Karturbis/2D_Printer/electronics/main_housing.FCStd

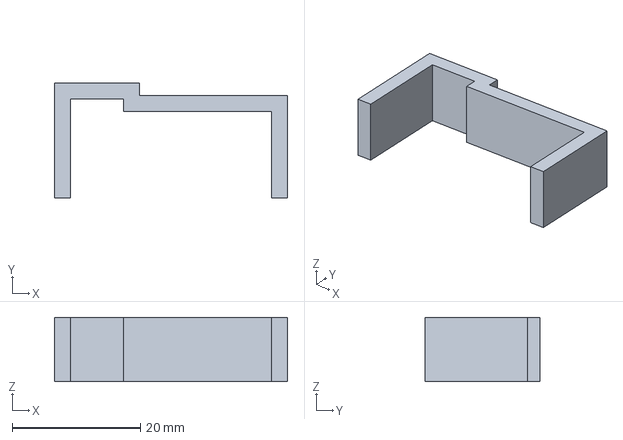
[picture p1: CAD file, 2025-06-26]
electronics/main_housing.FCStd
36.4 x 18.0 x 10.0 mm
