Karturbis/2D_Printer/electronics/stl_files/main_housing_front.stl

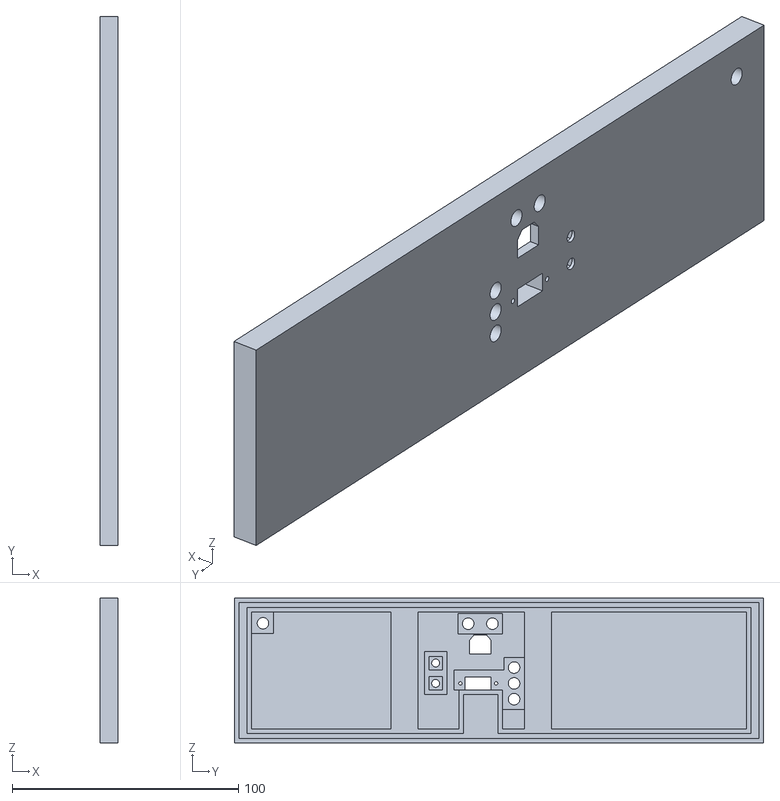
[picture p2: CAD file, 2025-06-12]
electronics/stl_files/main_housing_front.stl
8.00 x 234.0 x 64.0
