Karturbis/2D_Printer/electronics/stl_files/main_housing_back.stl

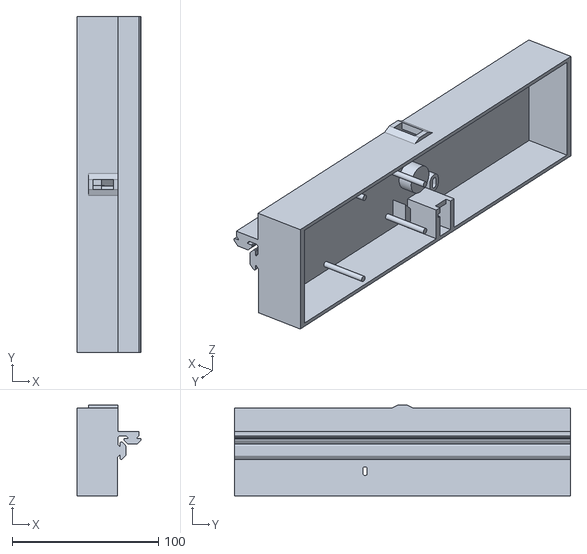
[picture p3: CAD file, 2025-06-11]
electronics/stl_files/main_housing_back.stl
44.0 x 230.0 x 62.0
