Karturbis/2D_Printer/Frame/Frame_foot.FCStd

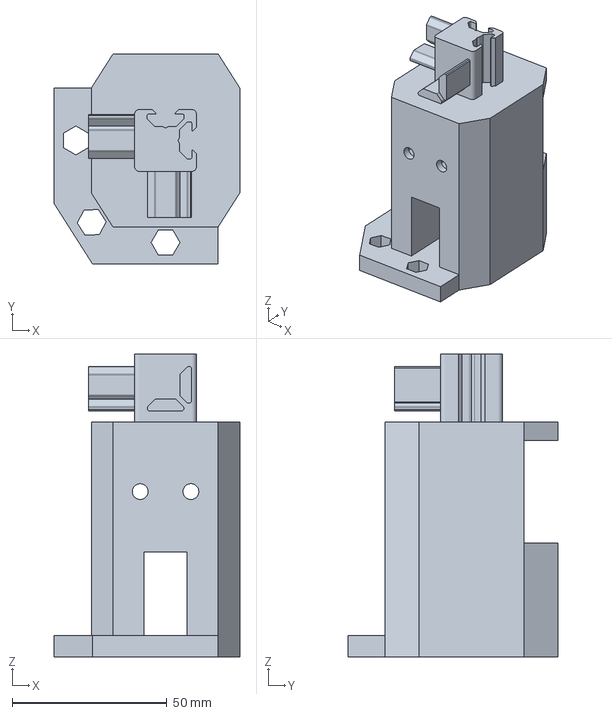
[picture p4: CAD file, 2025-06-16]
Frame/Frame_foot.FCStd
60.0 x 68.0 x 98.0 mm
