Karturbis/2D_Printer/toolhead/stl_files/one_wheel_top_pen_holder.stl

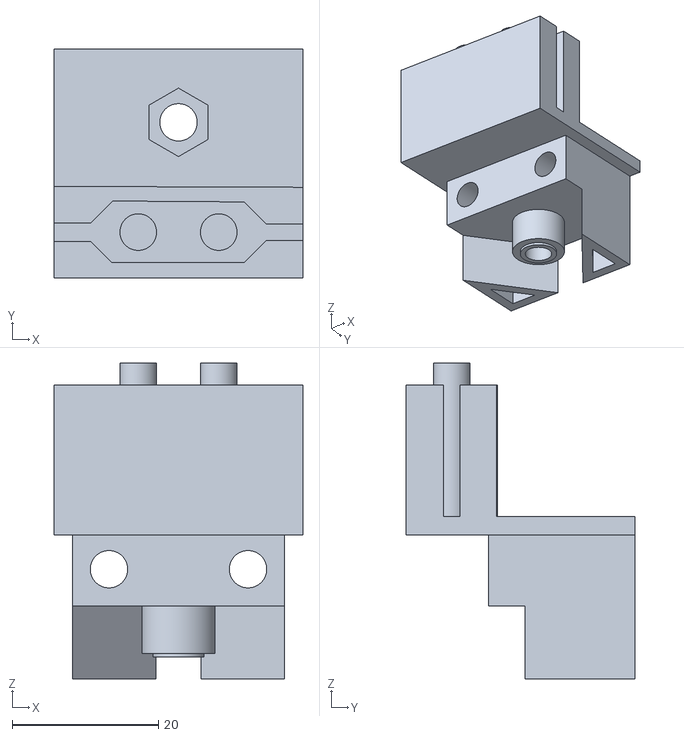
[picture p5: CAD file, 2025-06-10]
toolhead/stl_files/one_wheel_top_pen_holder.stl
34.0 x 31.3 x 43.2
