Karturbis/2D_Printer/toolhead/Toolhead.FCStd

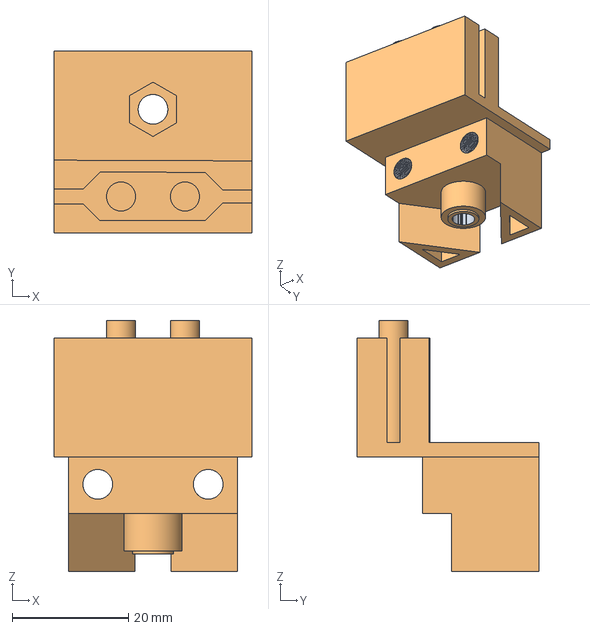
[picture p6: CAD file, 2025-06-10]
toolhead/Toolhead.FCStd
34.0 x 31.3 x 43.2 mm
one_wheel_top_pen_holder
one_wheel_top_pen_holder_mesh
