Karturbis/2D_Printer/v-slot_carriage/stl_files/y-axis_top_counter_part_left.stl

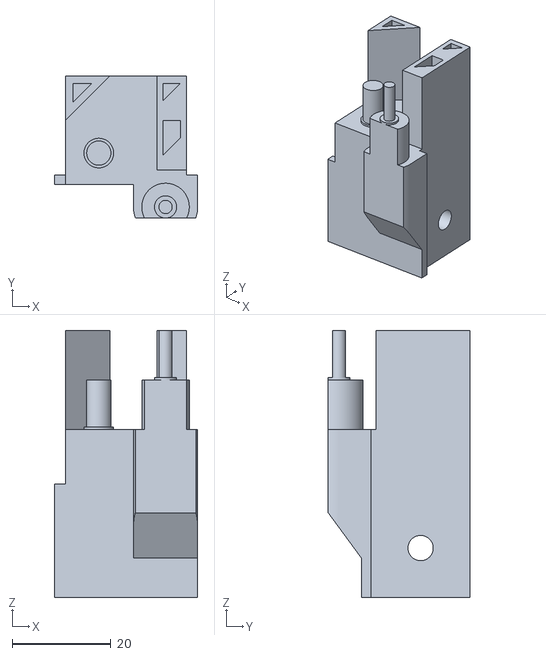
[picture p7: CAD file, 2025-06-05]
v-slot_carriage/stl_files/y-axis_top_counter_part_left.stl
29.0 x 28.8 x 54.0
