Karturbis/2D_Printer/v-slot_carriage/Vslot_carriage.FCStd

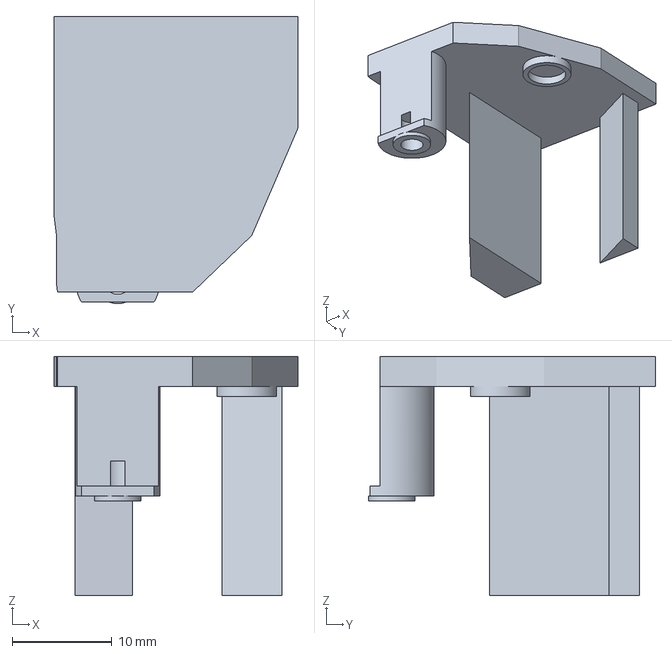
[picture p8: CAD file, 2025-06-05]
v-slot_carriage/Vslot_carriage.FCStd
24.5 x 28.9 x 24.0 mm
