Karturbis/2D_Printer/toolhead/stl_files/one_wheel_top_penholder_lid.stl

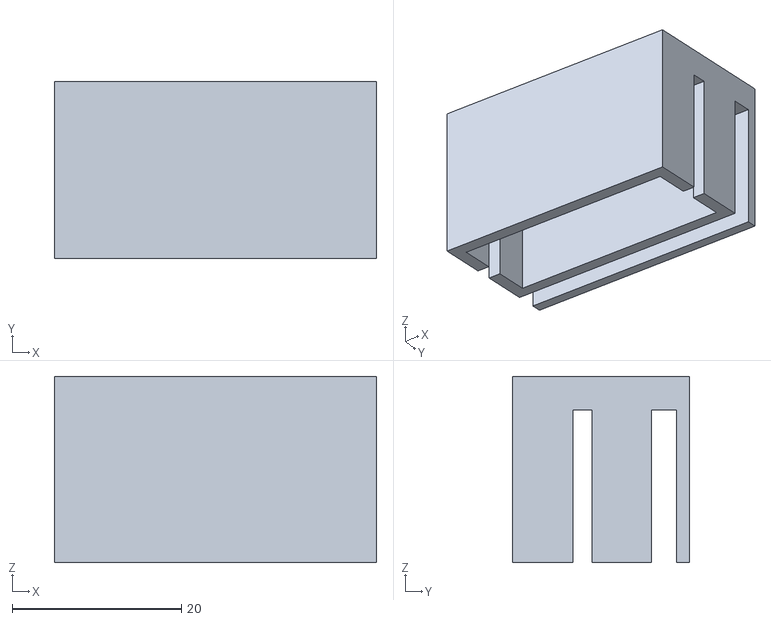
[picture p9: CAD file, 2025-06-10]
toolhead/stl_files/one_wheel_top_penholder_lid.stl
38.0 x 20.9 x 22.0
