Karturbis/2D_Printer/toolhead/stl_files/toolhead_pen_holder.stl

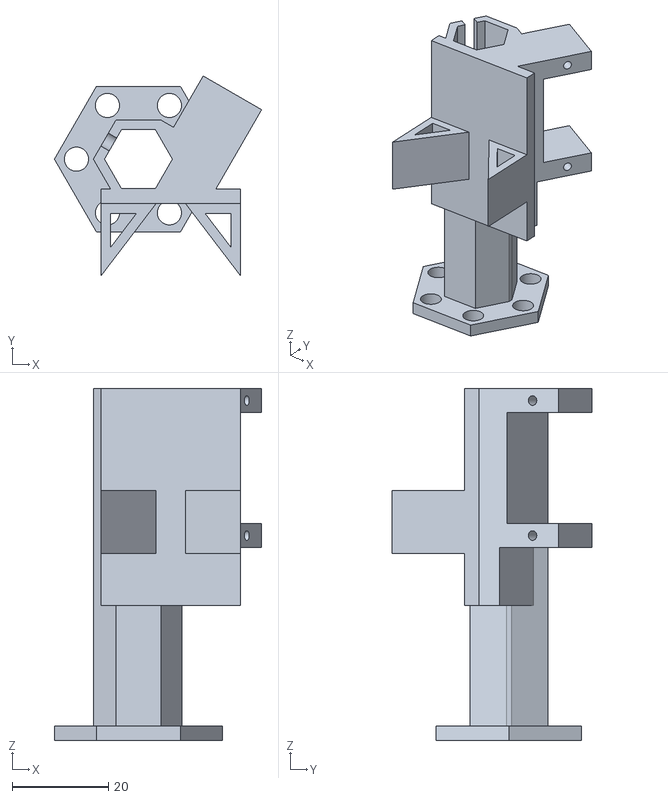
[picture p10: CAD file, 2025-05-23]
toolhead/stl_files/toolhead_pen_holder.stl
43.0 x 41.5 x 73.0
