Karturbis/2D_Printer/v-slot_carriage/stl_files/y-axis_top_counter_part_right.stl

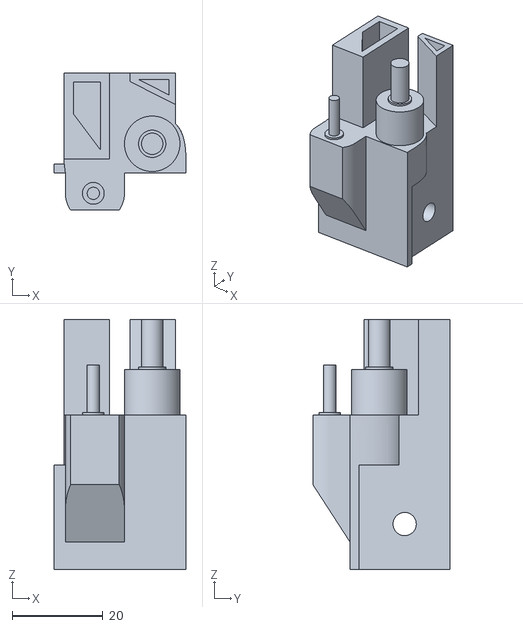
[picture p11: CAD file, 2025-06-04]
v-slot_carriage/stl_files/y-axis_top_counter_part_right.stl
29.0 x 30.2 x 55.0
