Karturbis/2D_Printer/toolhead/stl_files/Servo_Knob.stl

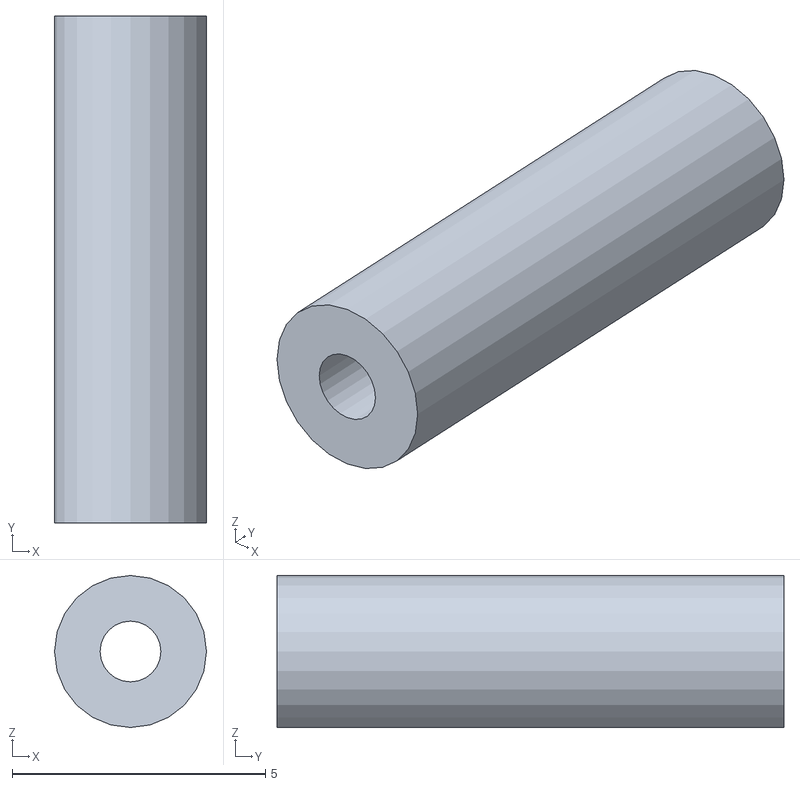
[picture p12: CAD file, 2025-05-19]
toolhead/stl_files/Servo_Knob.stl
3.00 x 10.0 x 3.00
