Karturbis/2D_Printer/v-slot_carriage/stl_files/y-axis_top_counter_part_left_lid.stl

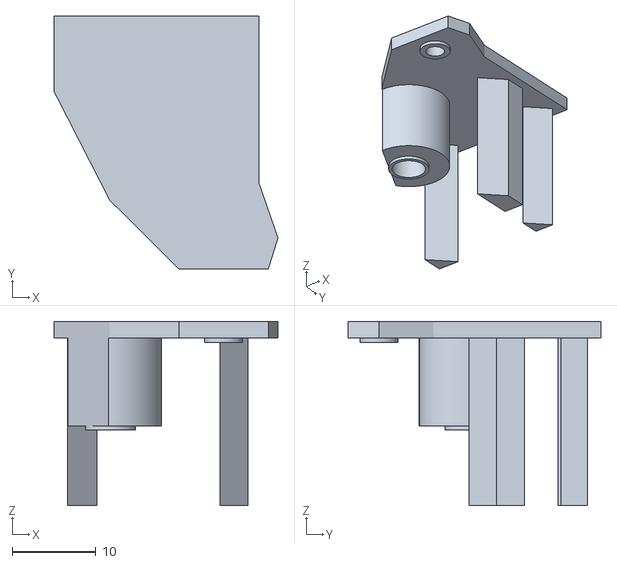
[picture p13: CAD file, 2025-06-04]
v-slot_carriage/stl_files/y-axis_top_counter_part_left_lid.stl
26.8 x 30.2 x 22.0
