Karturbis/2D_Printer/toolhead/stl_files/Pen_Holder_Stationary.stl

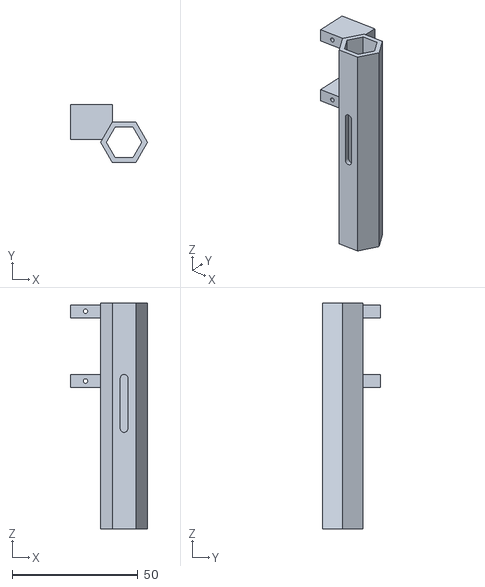
[picture p14: CAD file, 2025-05-19]
toolhead/stl_files/Pen_Holder_Stationary.stl
30.7 x 23.2 x 90.0
