Karturbis/2D_Printer/v-slot_carriage/stl_files/One_wheel_bottom.stl

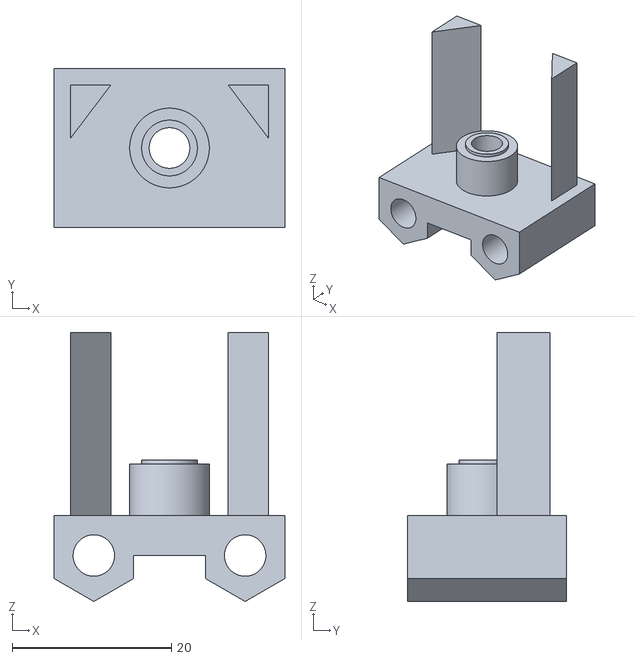
[picture p15: CAD file, 2025-06-02]
v-slot_carriage/stl_files/One_wheel_bottom.stl
29.0 x 20.0 x 33.8
