Karturbis/2D_Printer/toolhead/stl_files/Pen_Case.stl

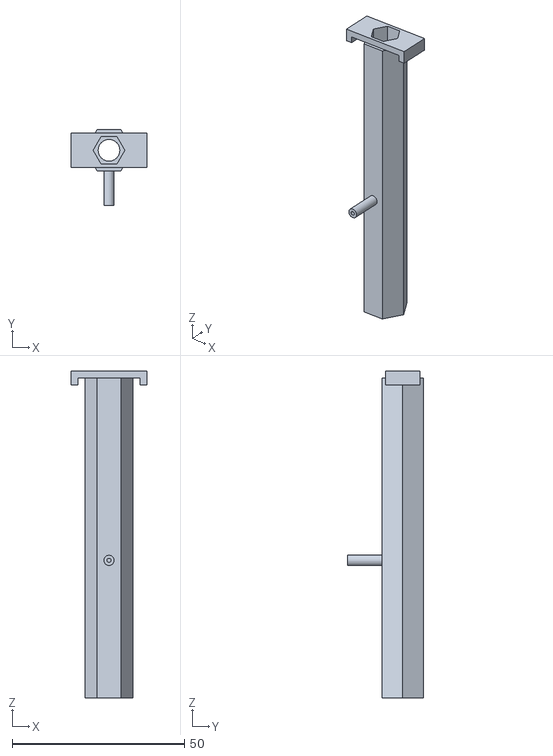
[picture p16: CAD file, 2025-05-19]
toolhead/stl_files/Pen_Case.stl
22.0 x 22.0 x 95.0
