Karturbis/2D_Printer/v-slot_carriage/stl_files/y-axis_top.stl

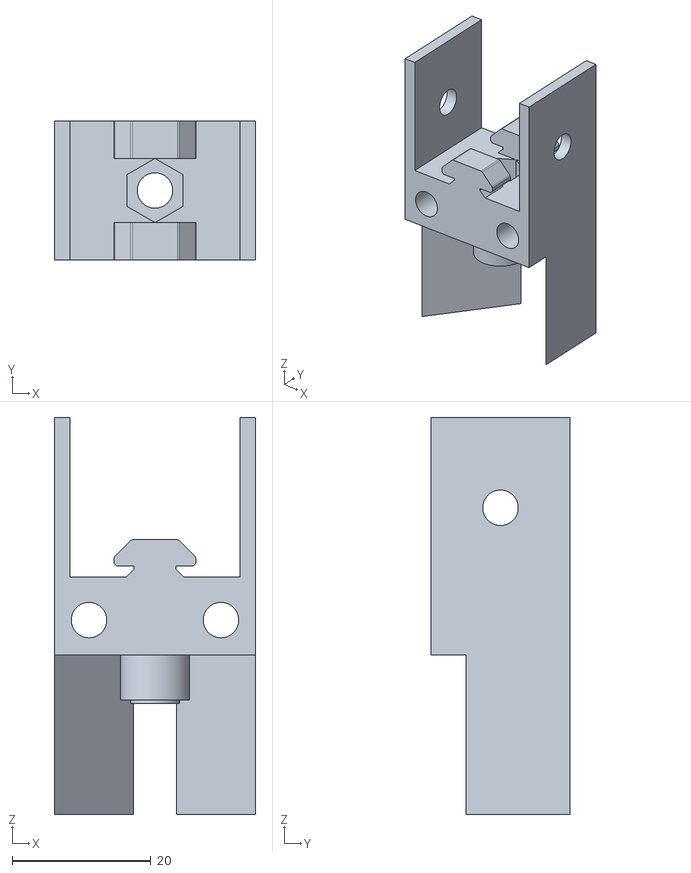
[picture p17: CAD file, 2025-06-02]
v-slot_carriage/stl_files/y-axis_top.stl
29.0 x 20.0 x 57.2
