Karturbis/2D_Printer/toolhead/stl_files/Pen_Cap.stl

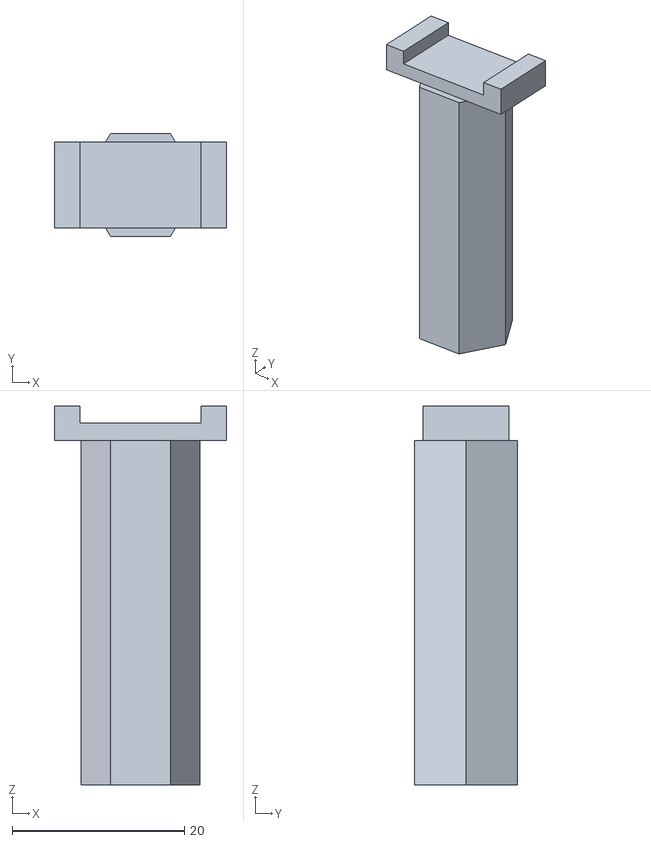
[picture p18: CAD file, 2025-05-14]
toolhead/stl_files/Pen_Cap.stl
20.0 x 12.0 x 44.0
