Karturbis/2D_Printer/v-slot_carriage/stl_files/y-axis_top_teeth_roller_lock.stl

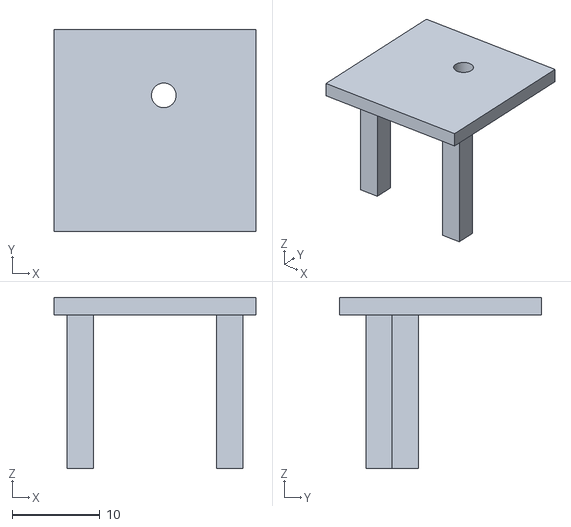
[picture p19: CAD file, 2025-06-02]
v-slot_carriage/stl_files/y-axis_top_teeth_roller_lock.stl
23.0 x 23.0 x 19.5
