Karturbis/2D_Printer/v-slot_carriage/stl_files/One_wheel_top_y-axis.stl

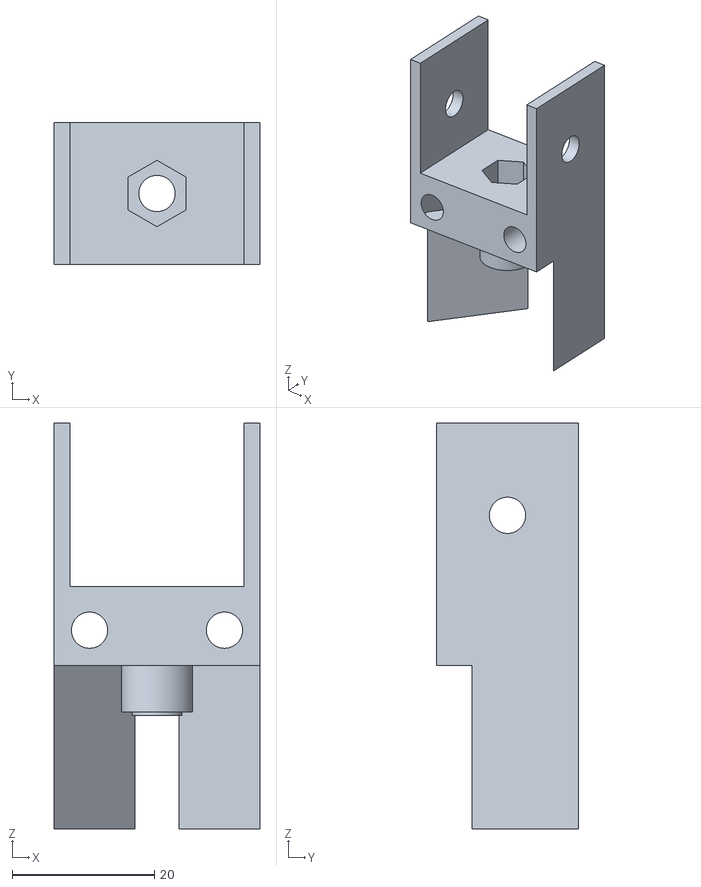
[picture p20: CAD file, 2025-05-22]
v-slot_carriage/stl_files/One_wheel_top_y-axis.stl
29.0 x 20.0 x 57.2
