Karturbis/2D_Printer/v-slot_carriage/stl_files/Belt_clip_test.stl

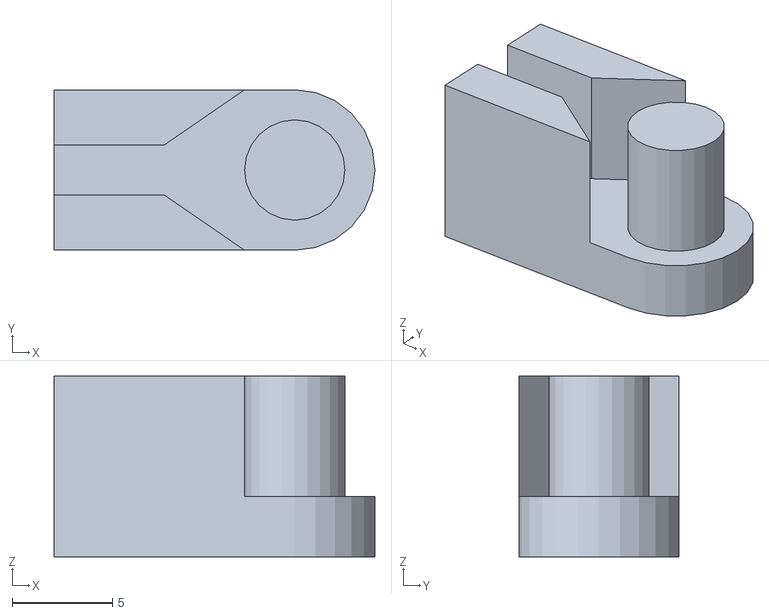
[picture p21: CAD file, 2025-05-21]
v-slot_carriage/stl_files/Belt_clip_test.stl
16.0 x 8.00 x 9.00
