Karturbis/2D_Printer/v-slot_carriage/stl_files/One_wheel_top.stl

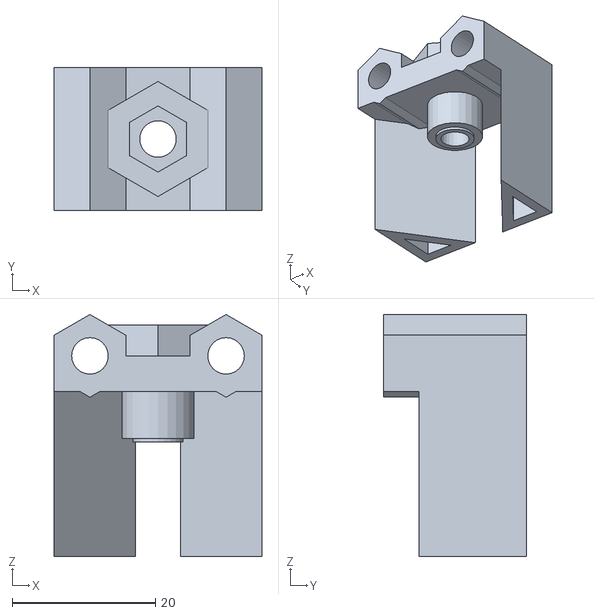
[picture p22: CAD file, 2025-05-21]
v-slot_carriage/stl_files/One_wheel_top.stl
29.0 x 20.0 x 33.8
