Karturbis/2D_Printer/v-slot_carriage/stl_files/Two_wheel_bottom.stl

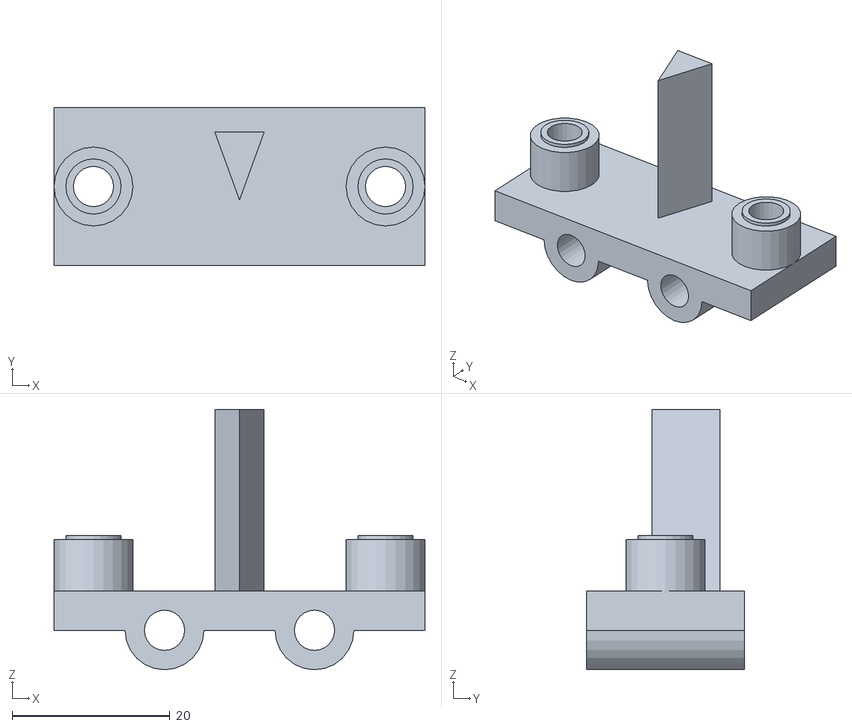
[picture p23: CAD file, 2025-05-21]
v-slot_carriage/stl_files/Two_wheel_bottom.stl
47.0 x 20.0 x 33.0
