Karturbis/2D_Printer/v-slot_carriage/stl_files/Two_wheel_top.stl

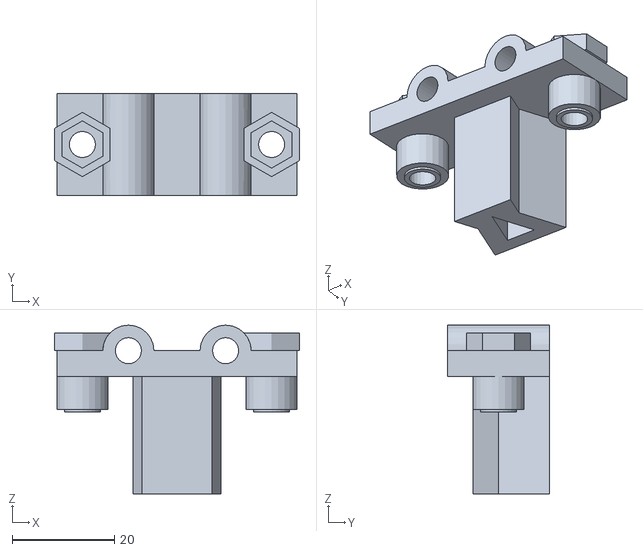
[picture p24: CAD file, 2025-05-21]
v-slot_carriage/stl_files/Two_wheel_top.stl
47.9 x 20.0 x 33.0
