Karturbis/2D_Printer/v-slot_carriage/stl_files/Wheel_small.stl

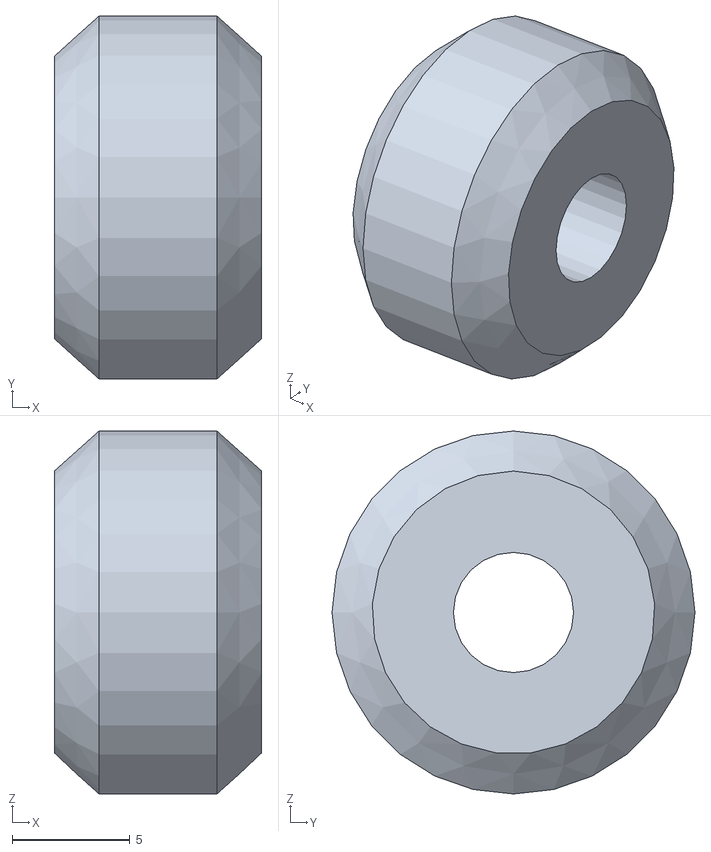
[picture p25: CAD file, 2025-05-20]
v-slot_carriage/stl_files/Wheel_small.stl
8.80 x 15.4 x 15.4
