Karturbis/2D_Printer/(list of files, cad)

Other CAD files:
electronics/stl_files/closing_clip.stl
Frame/stl_files/Frame_Foot_Motor_right.stl
v-slot_carriage/stl_files/y-axis_top_counter_part_right_lid.stl
Frame/stl_files/Frame_Foot_Motor_left.stl
Frame/stl_files/Frame_Foot.stl
Frame/stl_files/Frame_Foot_washers_bottom.stl
Frame/stl_files/Frame_foot_washers_top.stl
Frame/stl_files/Screw_Cap.stl
v-slot_carriage/stl_files/Nut_test.stl
