Karturbis/2D_Printer/(commit log)

2025-05-13 Add a CAD design for the feet of the printer frame
    [Frame_foot.FCStd]
2025-05-13 Export frame foot to .stl file
    [Frame_Foot.stl, Frame_foot.FCStd]
2025-05-13 Add Cad file for Toolhead, containing the pen cap.
    [Toolhead.FCStd]
2025-05-13 Start designing the Pen case, adding general structure and rubber band holder
    [Toolhead.FCStd]
2025-05-14 Finish designing the pen case
    [Toolhead.FCStd]
2025-05-14 Add the stationary part of the pen holder with a mount for the servo motor
    [Toolhead.FCStd]
2025-05-14 Convert bodys to meshes and export meshes to .stl files
    [Pen_Cap_Body.stl, Pen_Case_Body.stl, Pen_Holder_Stationary.stl, Toolhead.FCStd]
2025-05-14 Redesign Pen case, so it does not have to be printed inside of the stationary pen holder
    [Toolhead.FCStd]
2025-05-14 Export new Stl files
    [Pen_Case_Body.stl, Servo_Knob.stl]
2025-05-14 remove "body" from end of file name
    [Pen_Cap.stl, Pen_Case.stl]
2025-05-15 change inner diameter of the servo knob to 1.2 mm
    [Servo_Knob_1_2mm_inner.stl, Toolhead.FCStd]
2025-05-15 inital commit of toolhead servo test software
2025-05-15 change servo position on toolhead to redoce stress on servo knob
    [Pen_Holder_Stationary_02.stl, Toolhead.FCStd]
2025-05-15 add automatic mode to servo test (not working yet)
    [Toolhead_servo_test.ino]
2025-05-15 attach servo knob permanently to pen case
    [Pen_Case.stl, Toolhead.FCStd]
2025-05-19 Add Vslot_carriage.FCstd, design test for the self securing nuts
    [Toolhead.FCStd, Vslot_carriage.FCStd]
2025-05-19 Finish designing the nut test and export nut test as .stl file
    [Nut_test.stl, Vslot_carriage.FCStd]
2025-05-20 Finish designing the top part of the one-wheel side of the Vslot carriage
    [Vslot_carriage.FCStd]
2025-05-20 Finish designing the bottom part of the One-wheel part
    [Vslot_carriage.FCStd]
2025-05-20 Finish designing the top part of the two-wheel carriage part
    [Vslot_carriage.FCStd]
2025-05-20 start designing the bottom part of the two wheel side of the carriage
    [Vslot_carriage.FCStd]
2025-05-20 start creating a small wheel
    [Vslot_carriage.FCStd]
2025-05-20 export the carriage_parts
    [One_wheel_bottom.stl, One_wheel_top.stl, Two_wheel_bottom.stl, Two_wheel_top.stl]
2025-05-20 reorganize the repo, finish designing small wheel for testing purposes
    [Nut_test.stl, One_wheel_bottom.stl, One_wheel_top.stl, Pen_Cap.stl, Pen_Case.stl, Pen_Holder_Stationary.stl, Servo_Knob.stl, Toolhead.FCStd]
2025-05-20 adjust wheel hole size
    [Wheel_small.stl]
2025-05-20 update hole sizes
    [Vslot_carriage.FCStd]
2025-05-20 Redesign the carriage parts, so the connectors are more stable and the screw holes fit the screws
    [Vslot_carriage.FCStd]
2025-05-21 export updated carriagees to stl
    [One_wheel_top.stl, Two_wheel_bottom.stl, Two_wheel_top.stl]
2025-05-21 update one_wheel_bottom.stl to the updated carriage system
    [One_wheel_bottom.stl]
2025-05-21 Update the one-wheel carriage to make sure the nut slots have enough strength
    [One_wheel_bottom.stl, One_wheel_top.stl, Vslot_carriage.FCStd]
2025-05-21 design a belt clip
    [Belt_clip_test.stl, Vslot_carriage.FCStd]
2025-05-21 update nut slot size and ensure the one-wheel carriage can slot together fully
    [Vslot_carriage.FCStd]
2025-05-21 add y-axis top side carriage
    [One_wheel_top_y-axis.stl, Vslot_carriage.FCStd]
2025-05-22 Redesign the y-axis top part of the carriage, update the stl files of the one-wheel part of the carriage
    [One_wheel_bottom.stl, One_wheel_top_y-axis.stl, Vslot_carriage.FCStd]
2025-05-23 Design a universal tool head adapter, to attach the toolhead to the carriage and design a tool head
    [Toolhead.FCStd, Vslot_carriage.FCStd]
2025-05-23 export new pen holder toolhead to stl
    [one_wheel_top_pen_holder.stl, toolhead_pen_holder.stl]
2025-06-01 start to design the counterpart for the y-axsis wagon top
    [Frame_foot.FCStd, Toolhead.FCStd, Vslot_carriage.FCStd]
2025-06-01 design the one top counter part for the y-axis car
    [Toolhead.FCStd, Vslot_carriage.FCStd]
2025-06-02 finish the one of the two y-axis top counter parts
    [Vslot_carriage.FCStd]
2025-06-02 Add supports to the y-axis top counter part
    [Vslot_carriage.FCStd]
2025-06-02 mesh and export y-axis top parts
    [Vslot_carriage.FCStd, y-axis_top_counter_part.stl, y-axis_top_teeth_roller_lock.stl]
2025-06-02 mesh and export y-axis car top
    [Vslot_carriage.FCStd, y-axis_top.stl]
2025-06-02 fix broken y-axis_top part
    [Vslot_carriage.FCStd, y-axis_top.stl]
2025-06-02 remove unnecessary supports from y-axis top counter part and adjust tolerances for 3D-printing
    [Vslot_carriage.FCStd, y-axis_top_counter_part.stl, y-axis_top_counter_part_left.stl]
2025-06-02 design the y-axis top counter part fo rthe right side
    [Vslot_carriage.FCStd, y-axis_top_counter_part_right.stl]
2025-06-02 widen screwholes on one wheel bottom part
    [One_wheel_bottom.stl, Vslot_carriage.FCStd]
2025-06-02 add belt holders to the one wheel top pen holder part
    [Toolhead.FCStd, one_wheel_top_pen_holder.stl]
2025-06-02 redesign the y-axis top counter part left, so it fits the belt heights of the toolhead belt clip and also add a lid, so it can be used upside down
    [Vslot_carriage.FCStd, y-axis_top_counter_part_left.stl, y-axis_top_counter_part_left_lid.stl]
2025-06-02 adjust height of washers
    [Toolhead.FCStd, Vslot_carriage.FCStd]
2025-06-04 fix too close spacing and bad connectors on y-axis top counter part left
    [Vslot_carriage.FCStd, y-axis_top_counter_part_left.stl]
2025-06-04 change connector on y-axis top counter part lid accordingly to the connection system change on y-axis top counter part left
    [Vslot_carriage.FCStd, y-axis_top_counter_part_left_lid.stl]
2025-06-04 update design for y-axis top counterpart right
    [Vslot_carriage.FCStd, y-axis_top_counter_part_right.stl]
2025-06-04 adjust width for the washer with teeth pin from 3mm to 2.7mm, so the washer fits on it
    [y-axis_top_counter_part_right.stl]
2025-06-04 design the lid for the right side y-axis top counterpart
    [Vslot_carriage.FCStd, y-axis_top_counter_part_right_lid.stl]
2025-06-04 change connection system on right side of y-axis top counter part
    [Vslot_carriage.FCStd, y-axis_top_counter_part_right.stl, y-axis_top_counter_part_right_lid.stl]
2025-06-04 design freame feet with motor holder, add a directory for frame files
    [Frame_Foot.stl, Frame_Foot_Motor_left.stl, Frame_Foot_Motor_right.stl, Frame_foot.FCStd]
2025-06-04 make it possible for nuts to slit into the v-slot profile, where the right side y-axsis top counterpart is
    [Vslot_carriage.FCStd, y-axis_top_counter_part_right.stl]
2025-06-04 start designing the top part of the frame foot, which contains the washers
    [Frame_foot.FCStd]
2025-06-05 make motor frame feet uniform
    [Frame_Foot_Motor.stl, Frame_Foot_Motor_left.stl, Frame_Foot_Motor_right.stl, Frame_foot.FCStd]
2025-06-05 finish designing the top part of the frame foot with washers, start designing the bottom part
    [Frame_foot.FCStd, Frame_foot_washers_top.stl]
2025-06-05 finish designing the bottom part of the washer franme foot
    [Frame_Foot_washers_bottom.stl, Frame_foot.FCStd]
2025-06-05 design srew cap, so the adjustment screws do not harm the stepper motors
    [Frame_foot.FCStd, Screw_Cap.stl]
2025-06-05 update scrw cap design
    [Frame_foot.FCStd, Screw_Cap.stl]
2025-06-05 adjust width of y-axis counterparts, to make sure the belt runs smoothly
    [Vslot_carriage.FCStd, y-axis_top_counter_part_left.stl, y-axis_top_counter_part_right_lid.stl]
2025-06-05 update hole depth of frame foot washers bottom
    [Frame_Foot_washers_bottom.stl, Frame_foot.FCStd]
2025-06-05 update toolhead, so the belt clip is in the middle of the v-slot profile
    [Toolhead.FCStd, one_wheel_top_pen_holder.stl]
2025-06-09 make the frame foot washers top more stable and add additional counterpart for v-slot profile to it
    [Frame_foot.FCStd]
2025-06-09 add slanted faces to the frame foot washers top, so it can be printed without high supports
    [Frame_foot.FCStd]
2025-06-10 Add a cap to the belt clips, so they do not break open
    [Toolhead.FCStd, one_wheel_top_pen_holder.stl, one_wheel_top_penholder_lid.stl]
2025-06-11 add housing for the electronic parts
    [main_housing.FCStd]
2025-06-11 create meshes from 3D bodies, export the meshes to .stl files
    [main_housing.FCStd, main_housing_back.stl, main_housing_front.stl]
2025-06-11 update front design and add a hole for the motor cables to the back
    [main_housing.FCStd]
2025-06-11 add LED to top right corner of the front part, update the .stl files
    [main_housing.FCStd, main_housing_back.stl, main_housing_front.stl]
2025-06-12 update the main_housing front, so the pushbuttons fit better into it
    [main_housing.FCStd, main_housing_front.stl]
2025-06-16 add more stable connectors to the motor frame feet, add nut slots at the bottom
    [Frame_Foot_Motor.stl, Frame_Foot_Motor_left.stl, Frame_Foot_Motor_right.stl, Frame_foot.FCStd]
2025-06-16 add screw holes to the motor frame feet
    [Frame_Foot_Motor_left.stl, Frame_Foot_Motor_right.stl]
2025-06-16 update the frame foot washers bottom part, so it can be screwed on to a building plate
    [Frame_Foot_washers_bottom.stl]
2025-06-17 update moveto function, add init_driver() function, start implementing the homing function
2025-06-18 start testing the stepper motors with the new TMC2208 drivers using differnet libraries
2025-06-18 adding connectivity with PC, add Motor control
2025-06-18 change hole depth in frame foot washers bottom
    [Frame_Foot_washers_bottom.stl]
2025-06-18 fix wrong offset of the v-slot profile holders in the motor feet
    [Frame_Foot_Motor_left.stl, Frame_Foot_Motor_right.stl]
2025-06-19 implement communication with computer, add toolhead() functions, add test_motor() function, start implementing homing fix Bugs in the move() function
    [config.h, firmware.ino]
2025-06-20 add tests for the serial connection and the toolhead servo motor
2025-06-20 implement engage and disengage toolhead functions, split move function into calculate steps and go steps, add (not yet working) option to use Accelstepper for the execution of going steps
2025-06-20 implement homing
2025-06-20 implement stopping the motors, if driving into a wall
2025-06-21 startting to write Software, that sends simple commands to the printer and is a better userinterface, than the raw printer commands
2025-06-21 start implementing a move_steps function, which can move in angles other than multiples of 1/4*pi. (Not working yet)
    [config.h, firmware.ino]
2025-06-21 add check_collision() function, add move_steps_diagonal_slope() function, that implements another algorithm to move the stepper in diagonal directions, start replacing accelstepper with Fastacelstepp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
2025-06-21 fix bug; program crashing, if using LOG comments
    [printer_control.py]
2025-06-21 add print file function
2025-06-22 fix command Number not correctly displayed, add possibility to move further than max printer length with one command
    [printer_control.py]
2025-06-22 fix variable name from non existing macreo_name to self.macro in method end_macro() line 152
    [printer_control.py]
2025-06-22 add Loglevel to the log messages, change the homing routine, to first home x-axis and than home y-axis
2025-06-22 add loglevel support, remove unneccesary listen() at the start of print_file() change Serial timeout to 20 seconds, so the computer does not send commands, while the printer is homing, because homing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
2025-06-22 update .gitignore, so ignoreing the print_files actually works
2025-06-22 add errorhandling to print_file() function
    [printer_control.py]
2025-06-23 fix bug, catching wrong error
    [printer_control.py]
2025-06-23 fix commect typos, change homeing to homing
    [firmware.ino]
2025-06-23 remove uneccesary code, fix bug when swapping X- and -Axis
    [firmware.ino]
2025-06-25 add change tool and bitshift led methods,
    fix copy pasting error in move_steps_diagonal_micros and move_steps diagonal_slope, which possibly fixes both functions (not tested yet)
    [config.h, firmware.ino]
2025-06-25 add Axis endswitches configaration programm, to print, see, which endswitches are which
2025-06-25 add safe failing to the connection process
    [printer_control.py]
2025-06-26 fix bug angle input not working
    [printer_control.py]
2025-06-26 fix bug in linear_interpolation_time, moving in wrong direction change code layout
    [firmware.ino]
2025-06-26 design a clip to close the main housing
    [closing_clip.stl, main_housing.FCStd]
2025-06-26 ad HOMING_MOVEBACK constant, now homing y-axis first
2025-06-26 fix bug printer not noticing, if it moves into the positive y -wall
    [config.h, firmware.ino]
2025-06-26 this time really fixing printer not noticing, if it runs into wall
    [firmware.ino]
2025-06-26 add a gui to the printer control
2025-06-26 change homing moveback to 500
2025-06-26 start implementing LED control
2025-06-26 remove gui, for better stability
    [printer_control.py]
2025-06-26 fix typo float to Float
    [firmware.ino]
2025-06-28 fix bug, using String instead of char
    [config.h]
2025-06-28 fix bug, nines not working, start testing the LEDs
    [firmware.ino]
2025-06-29 use Serial.fluch in the setup, reimplement error 5
    [firmware.ino]
2025-06-30 change y axis 0 to be at the side of the plotter opposite of the electronics housing
